ivanrulik/AnkleRehabRobot/docs/figs/controlDiag.jpg

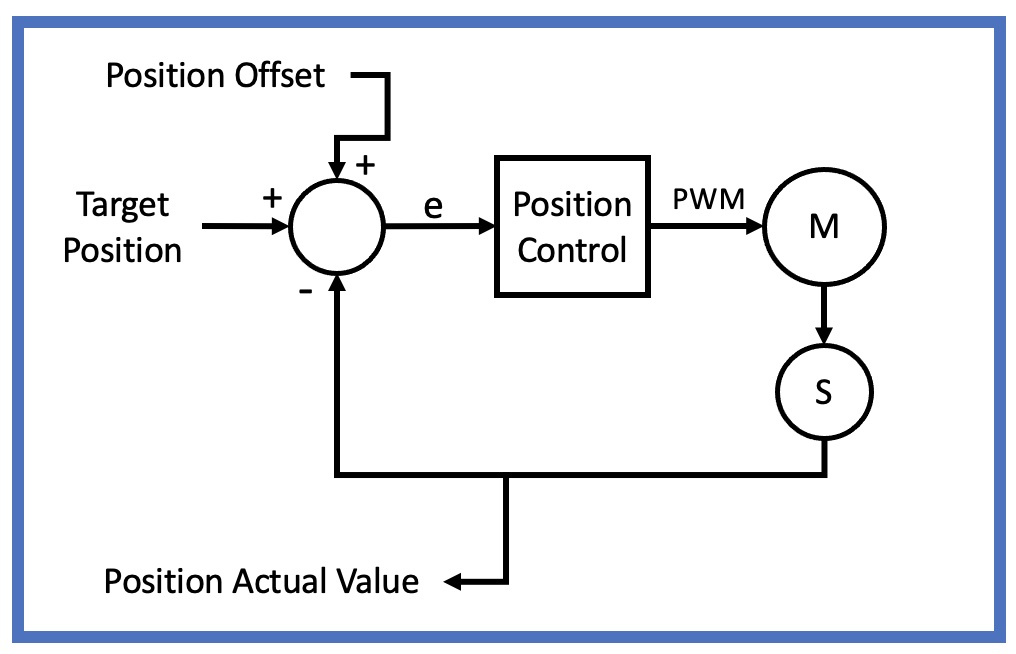
docs/figs/controlDiag.jpg
